ajayre/mpstune-o-matic/PCB/PCB Render.png

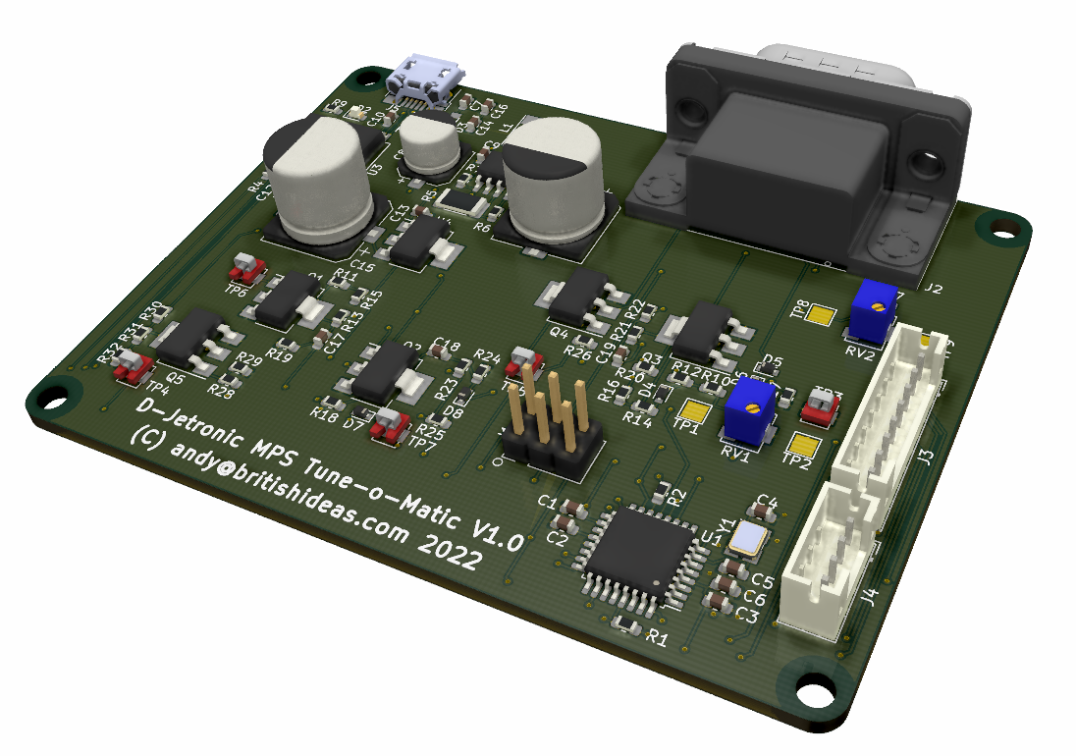
PCB/PCB Render.png
