ajayre/mpstune-o-matic/README.md

# mpstune-o-matic
D-Jetronic MPS Tune-o-Matic
