ajayre/mpstune-o-matic/Software Notes.txt

2. O2 tuned MPSs need to also state fuel pressure.

3. Multiple benchmark O2 tuned MPSs with different fuel pressures so user can choose which one matches their current fuel pressure

9. MPS profile has checkbox "unaltered" so we can automatically generate an average of all unaltered MPSs in the database.

11. Generate stats/report such as % change in pulse width from 0 inHg to 15 inHg
