ajayre/mpstune-o-matic/Simulation/Pressure Loop/AnnotatedSchematics.pptx

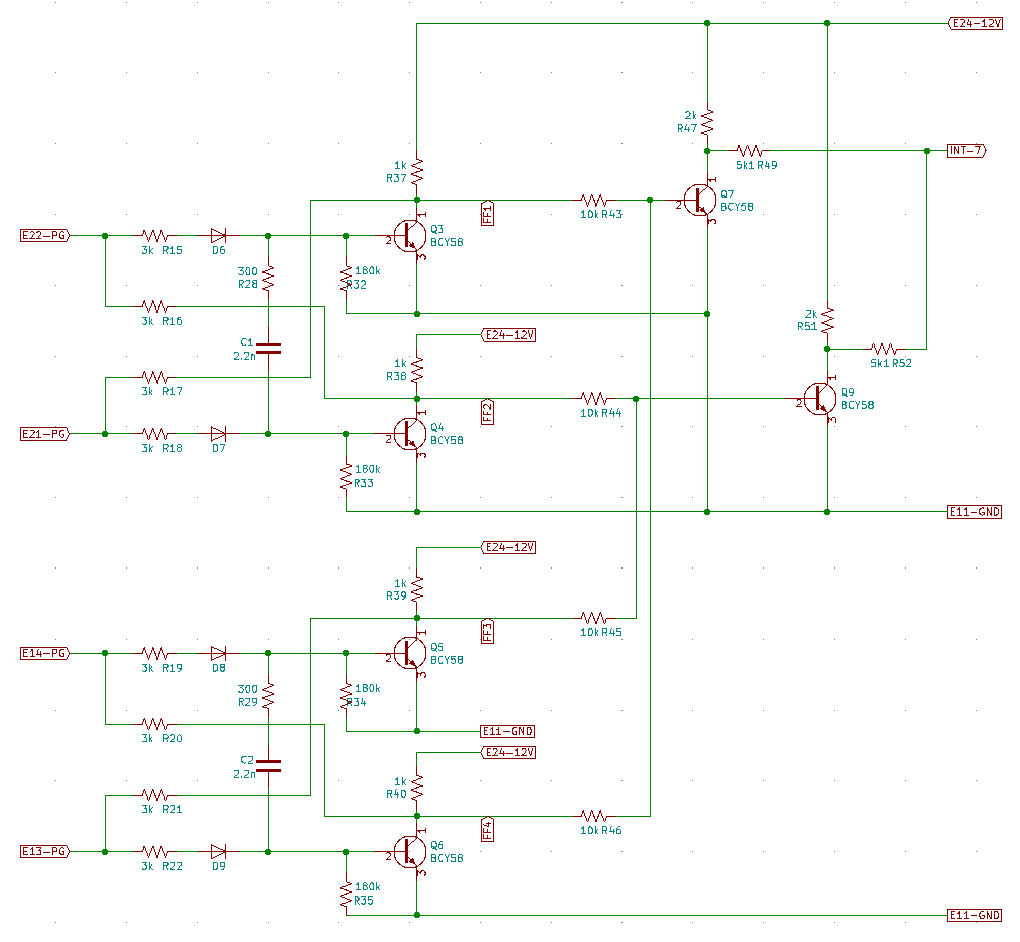
[picture p2: figure]

## Slide 2

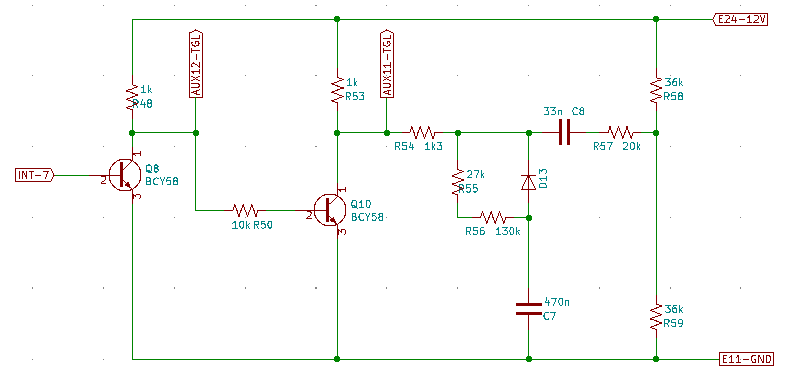
[picture p3: figure]

## Slide 3

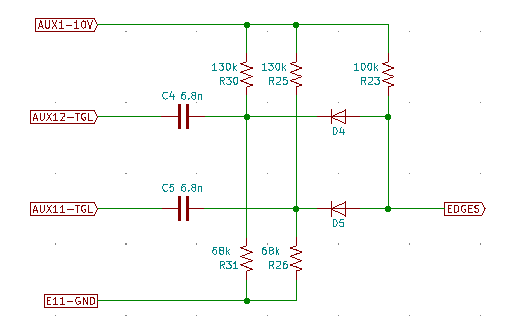
[picture p4: figure]

## Slide 4

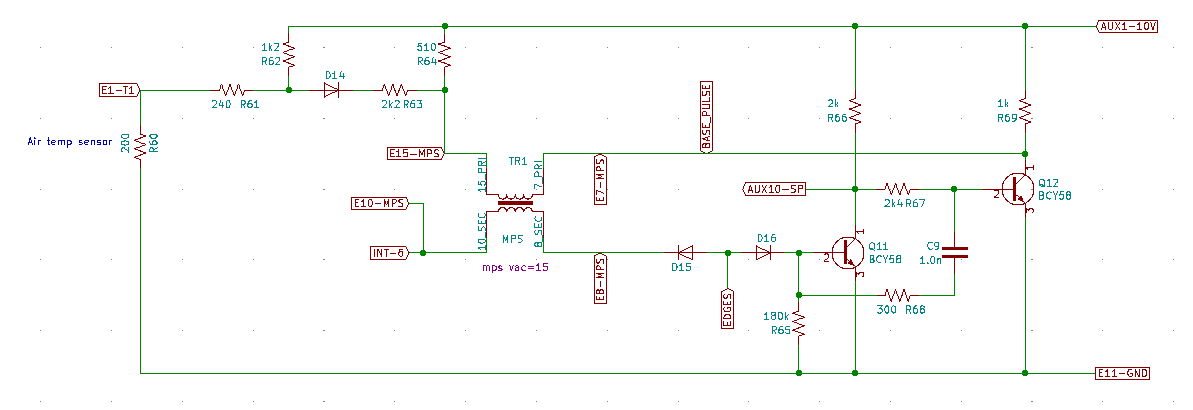
[picture p5: figure]
