ajayre/mpstune-o-matic/Simulation/MPS Stimulator/Waveforms.png

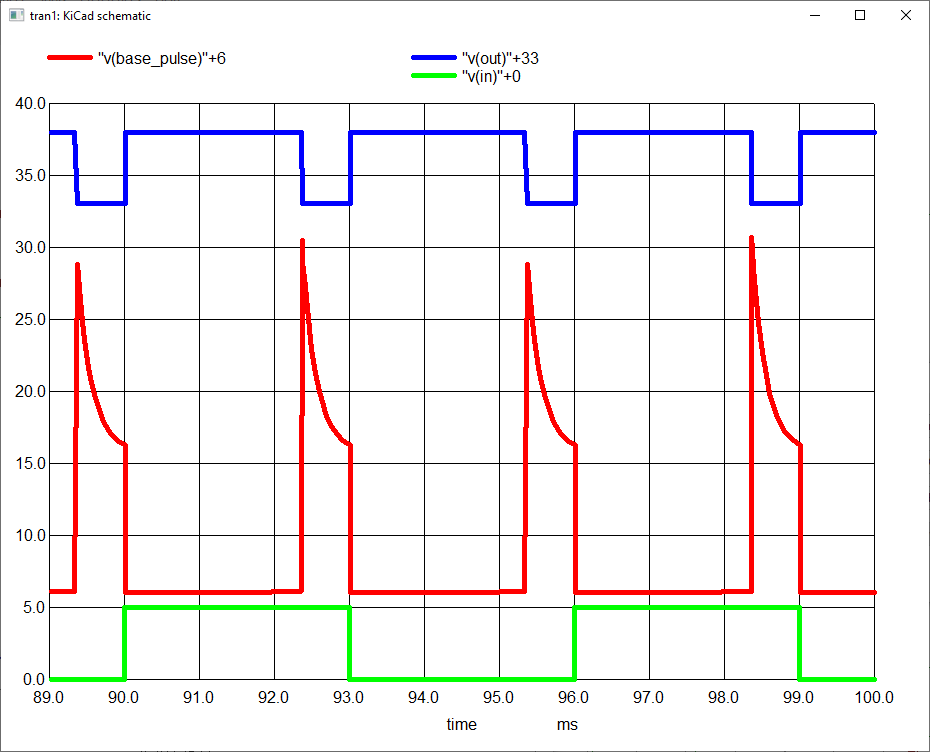
Simulation/MPS Stimulator/Waveforms.png
