ajayre/mpstune-o-matic/Simulation/Pressure Loop/BasePulseGeneration-0inHg.png

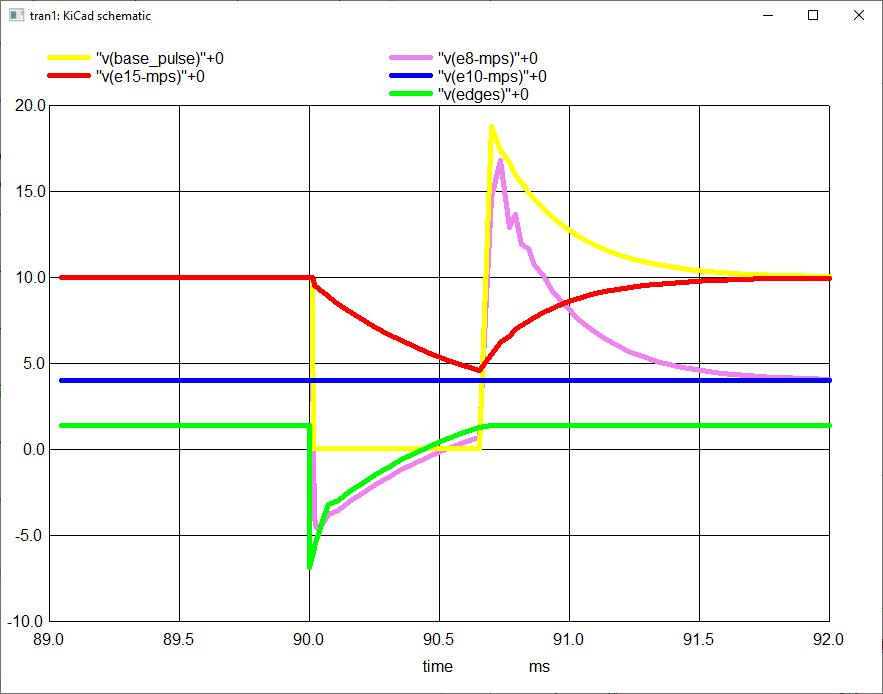
Simulation/Pressure Loop/BasePulseGeneration-0inHg.png
