ajayre/mpstune-o-matic/Simulation/Pressure Loop/BasePulseGeneration-Stacked-0inHg.png

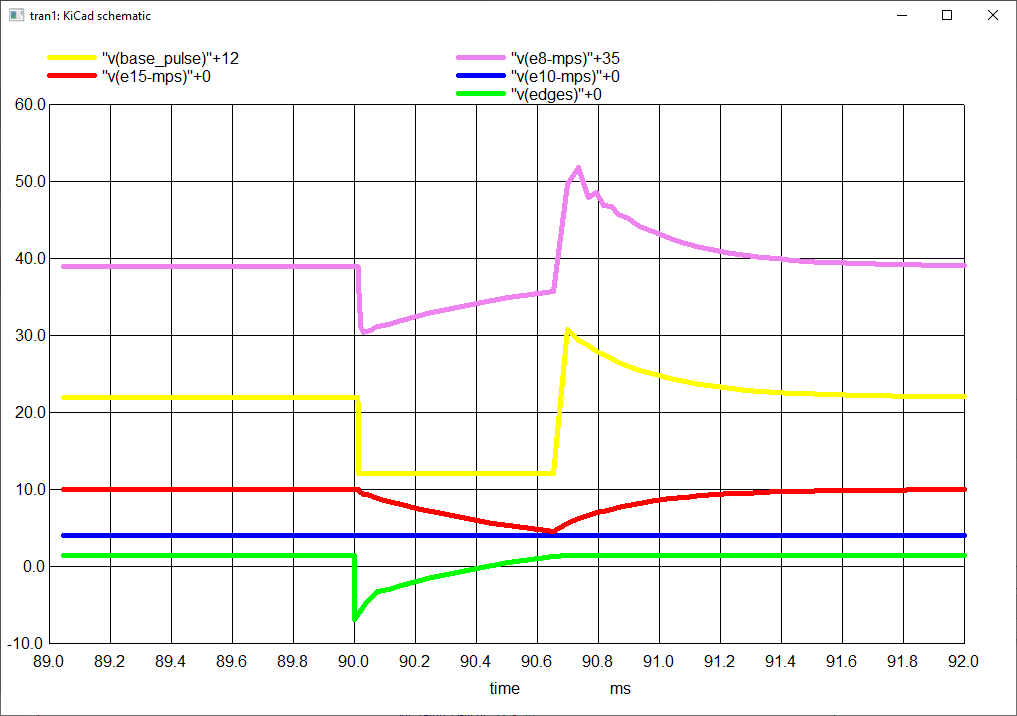
Simulation/Pressure Loop/BasePulseGeneration-Stacked-0inHg.png
