ajayre/mpstune-o-matic/Simulation/Pressure Loop/BasePulseGeneration-Stacked.png

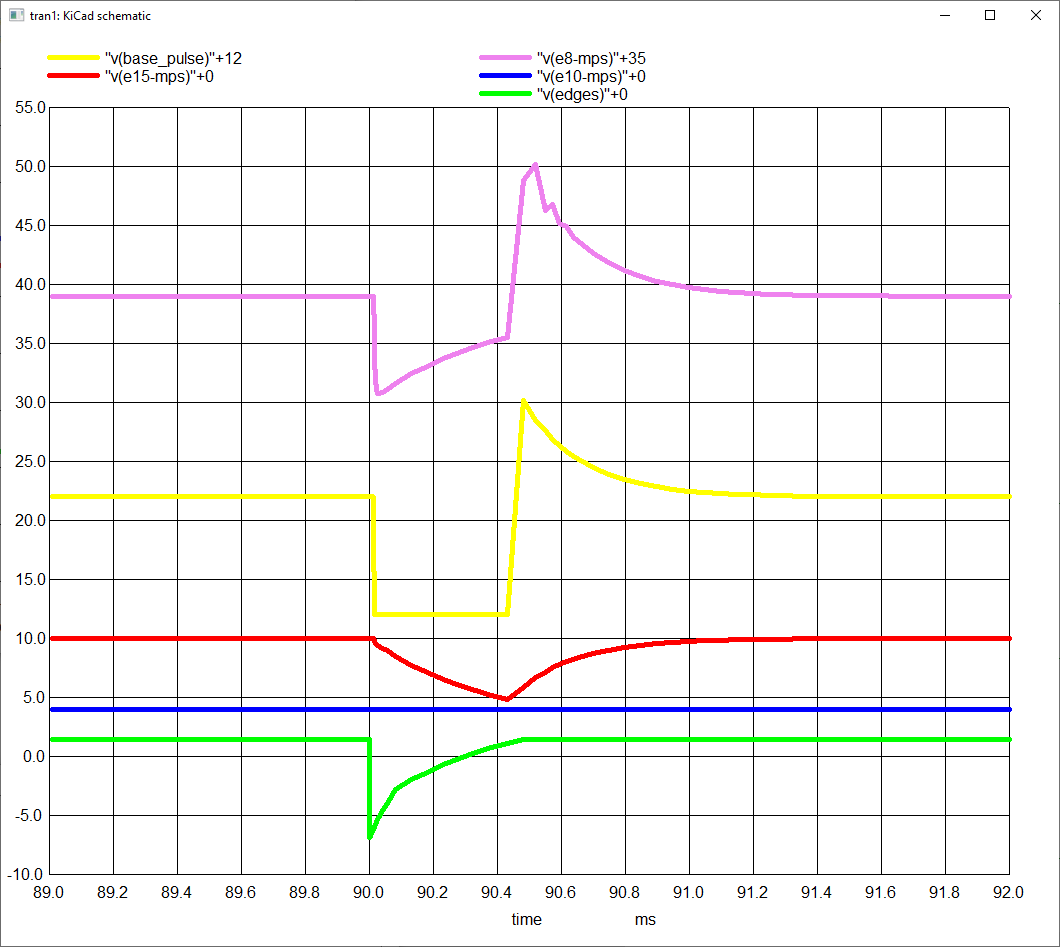
Simulation/Pressure Loop/BasePulseGeneration-Stacked.png
