ajayre/mpstune-o-matic/Simulation/Pressure Loop/BasePulseGeneration.png

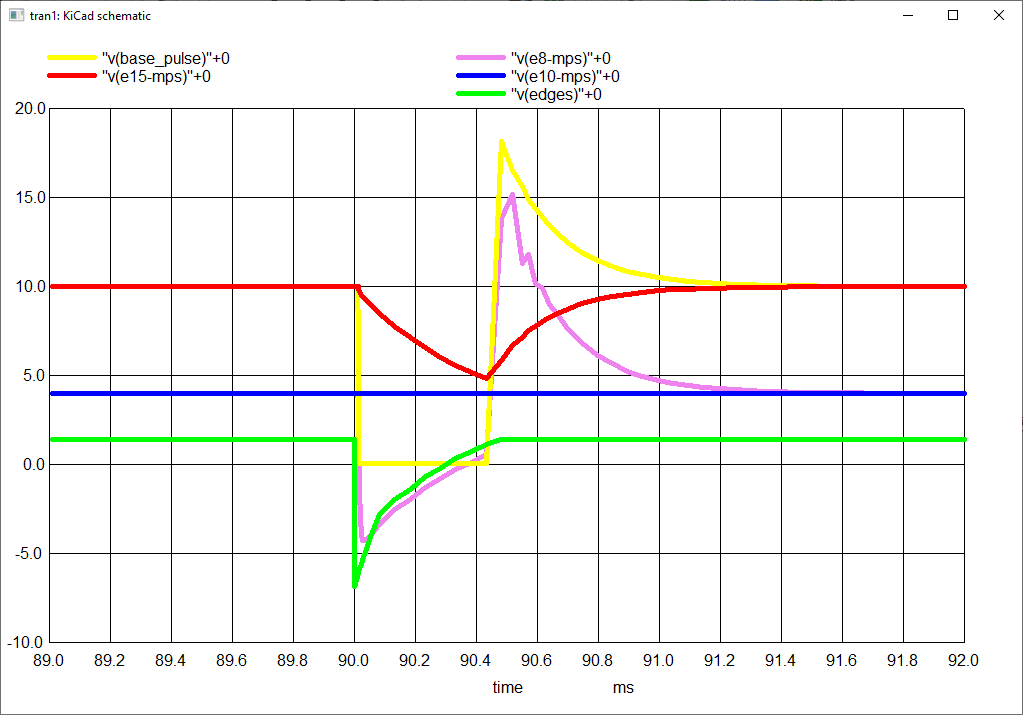
Simulation/Pressure Loop/BasePulseGeneration.png
