ajayre/mpstune-o-matic/Simulation/Pressure Loop/EdgeGeneration-sch-Annotated.png

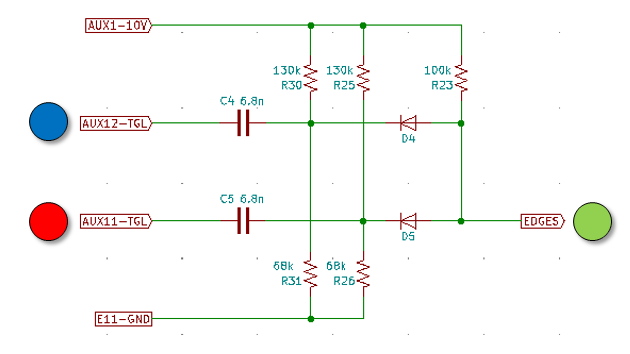
Simulation/Pressure Loop/EdgeGeneration-sch-Annotated.png
