ajayre/mpstune-o-matic/Simulation/Pressure Loop/EdgeGeneration.png

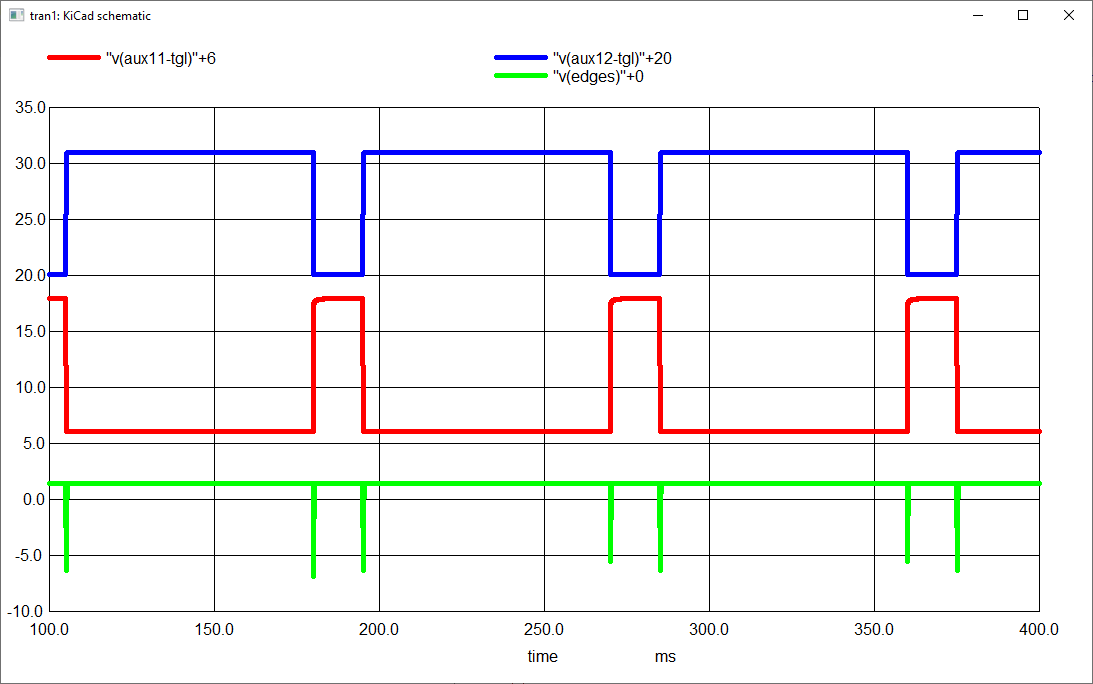
Simulation/Pressure Loop/EdgeGeneration.png
