ajayre/mpstune-o-matic/Simulation/Pressure Loop/EdgeGenerationCloseUp.png

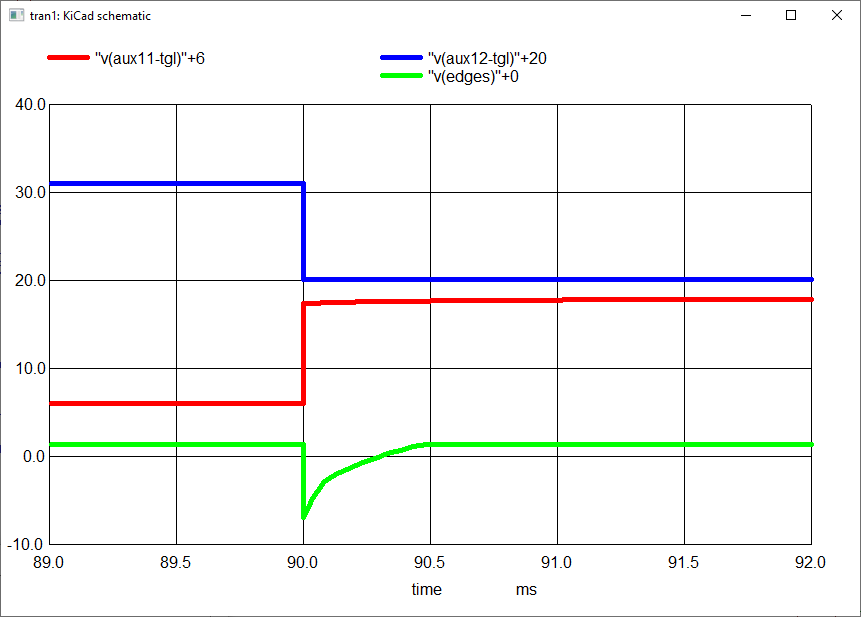
Simulation/Pressure Loop/EdgeGenerationCloseUp.png
