ajayre/mpstune-o-matic/Simulation/Pressure Loop/FlipFlopOutputs.png

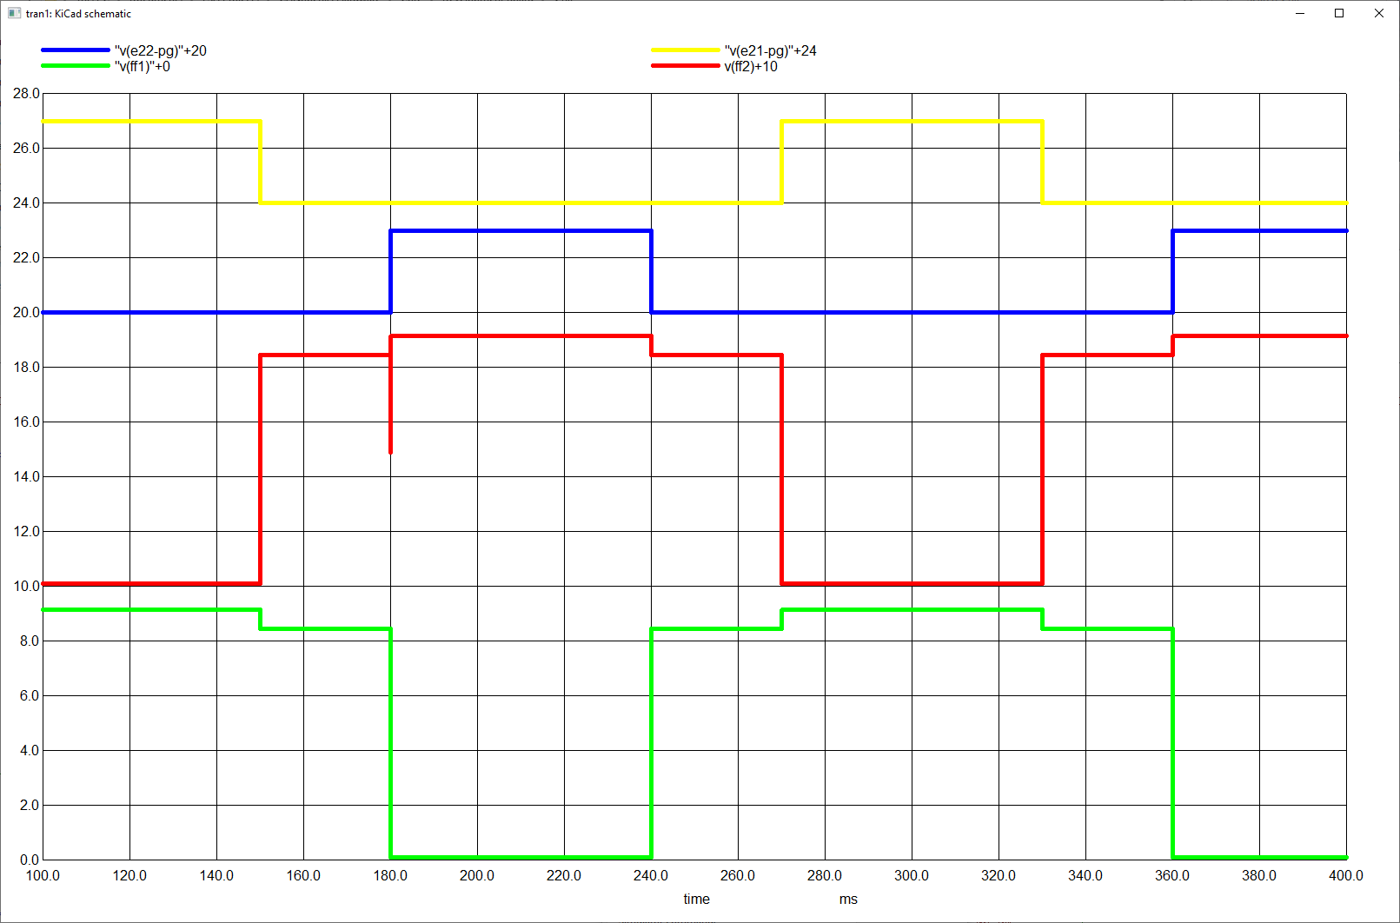
Simulation/Pressure Loop/FlipFlopOutputs.png
