ajayre/mpstune-o-matic/Simulation/Pressure Loop/PressureLoop-sch-Annotated.png

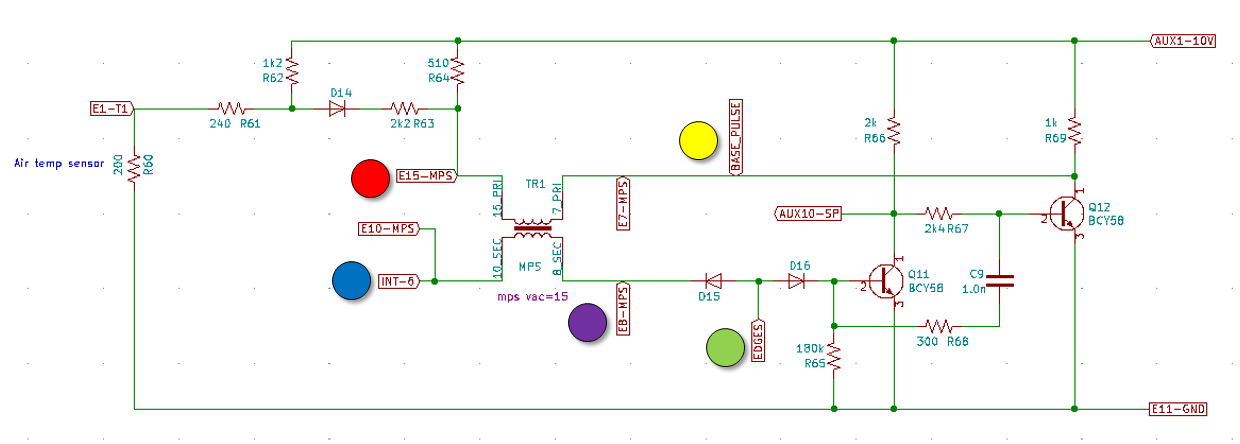
Simulation/Pressure Loop/PressureLoop-sch-Annotated.png
