ajayre/mpstune-o-matic/Simulation/Pressure Loop/PulseGenerator.png

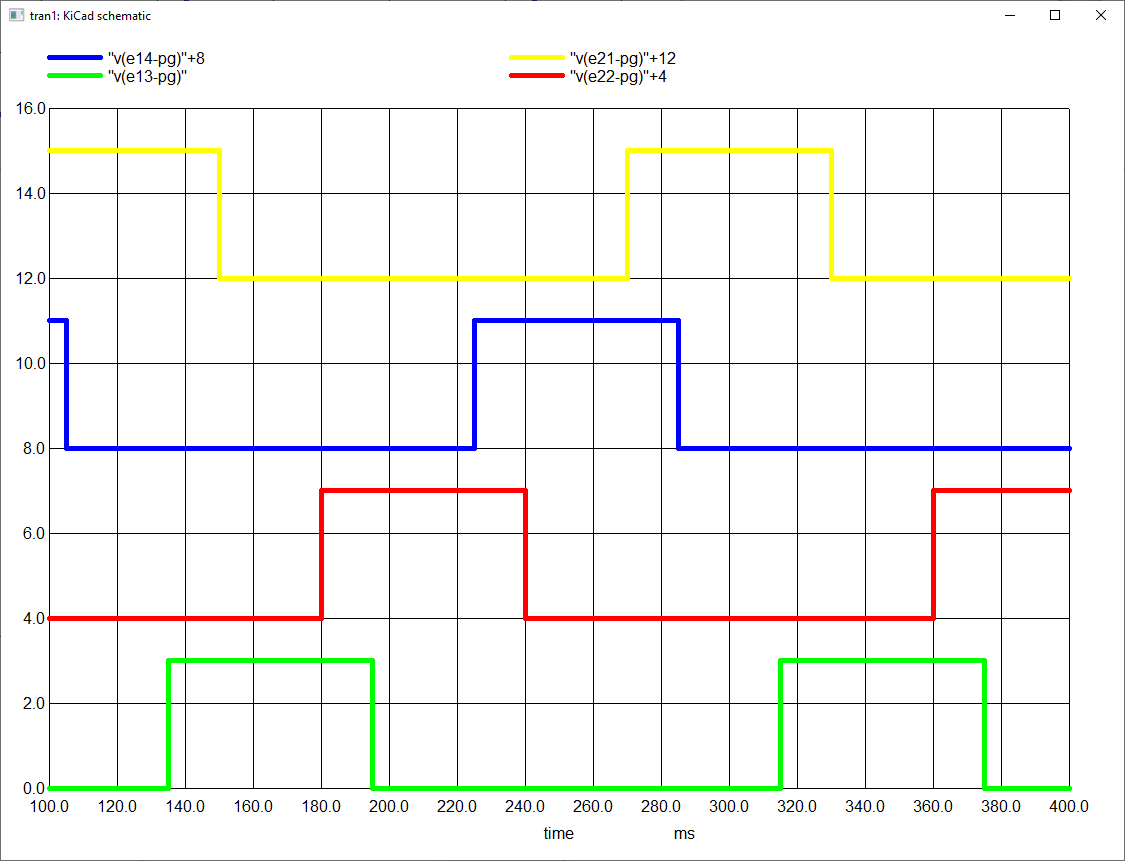
Simulation/Pressure Loop/PulseGenerator.png
