ajayre/mpstune-o-matic/Simulation/Pressure Loop/PulseGeneratorSignalProcessing-sch-Annotated.png

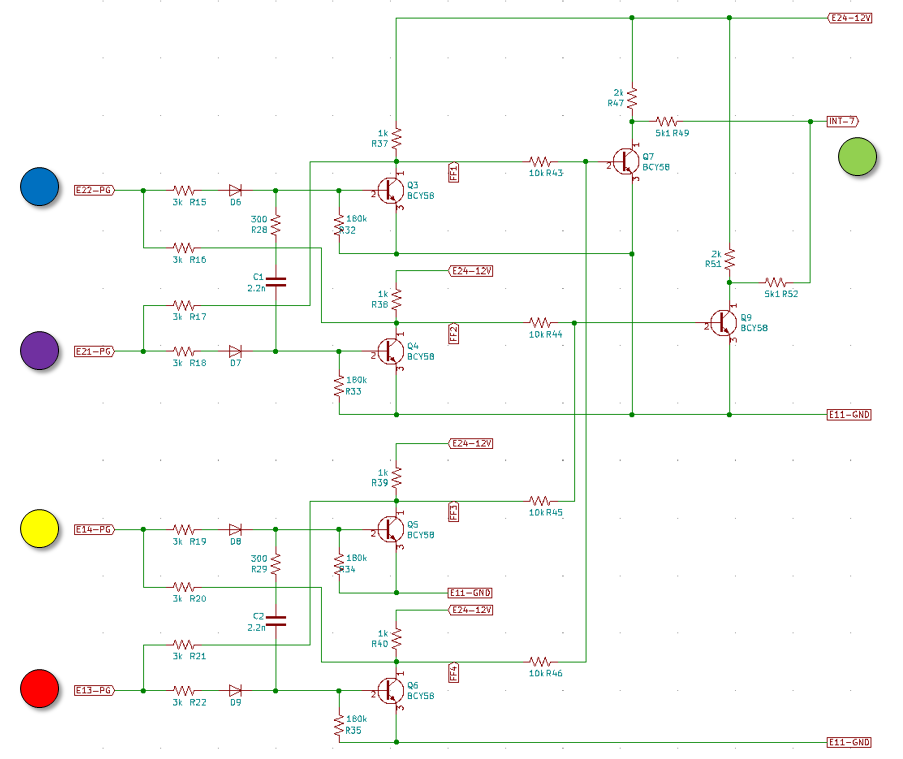
Simulation/Pressure Loop/PulseGeneratorSignalProcessing-sch-Annotated.png
