ajayre/mpstune-o-matic/Simulation/Pressure Loop/PulseGeneratorSignalProcessing.png

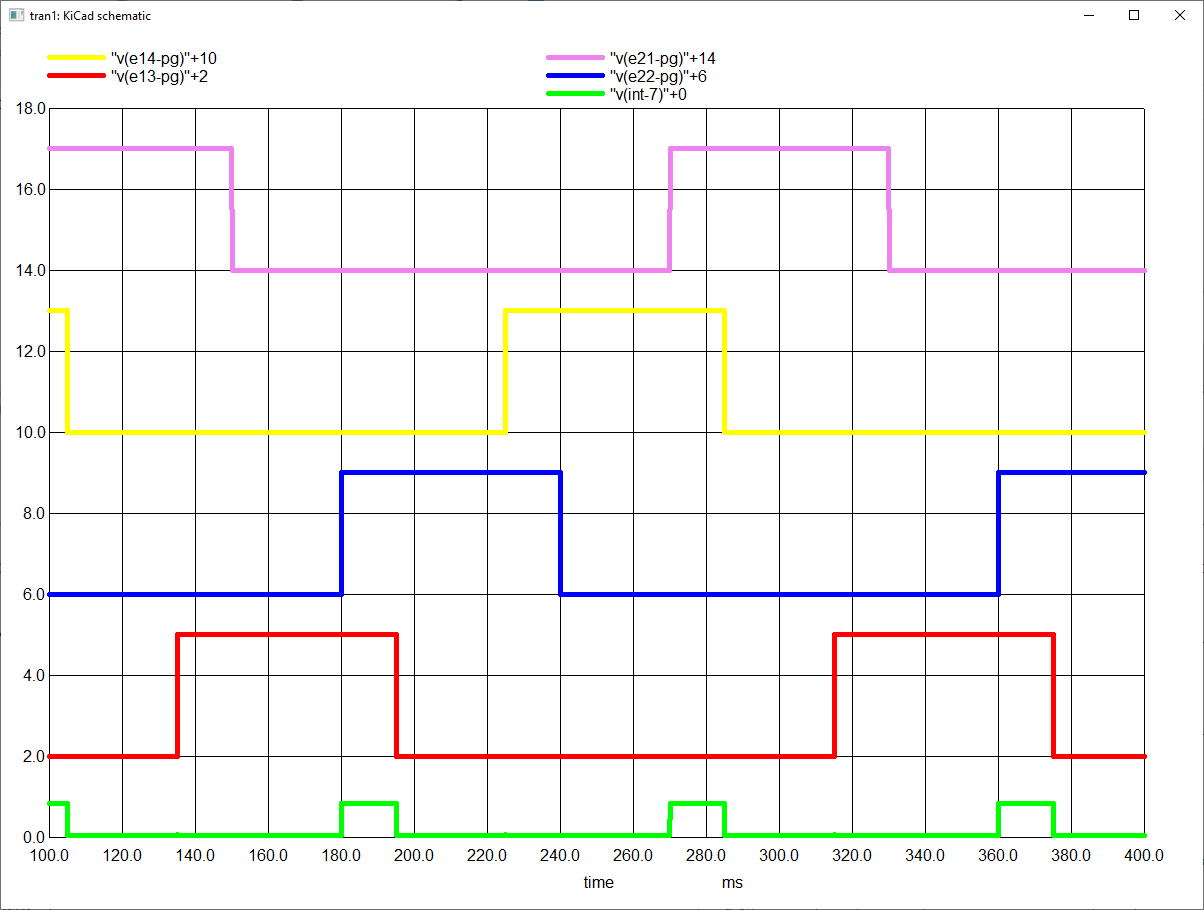
Simulation/Pressure Loop/PulseGeneratorSignalProcessing.png
