ajayre/mpstune-o-matic/Simulation/Pressure Loop/ToggleGeneration-sch-Annotated.png

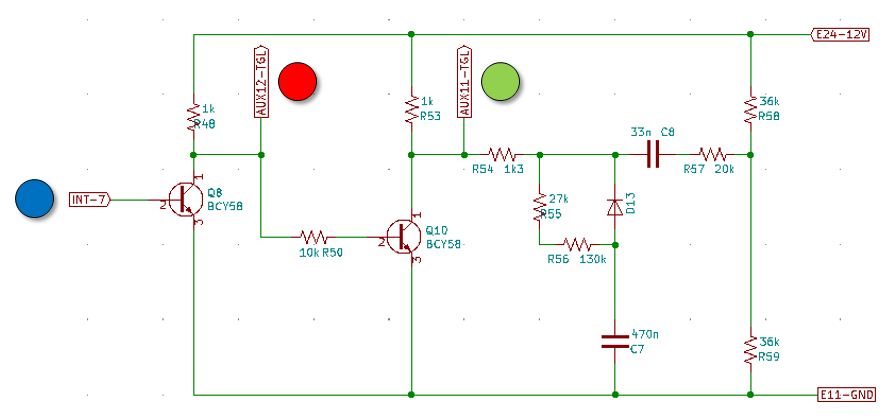
Simulation/Pressure Loop/ToggleGeneration-sch-Annotated.png
