ajayre/mpstune-o-matic/Simulation/Pressure Loop/ToggleGeneration.png

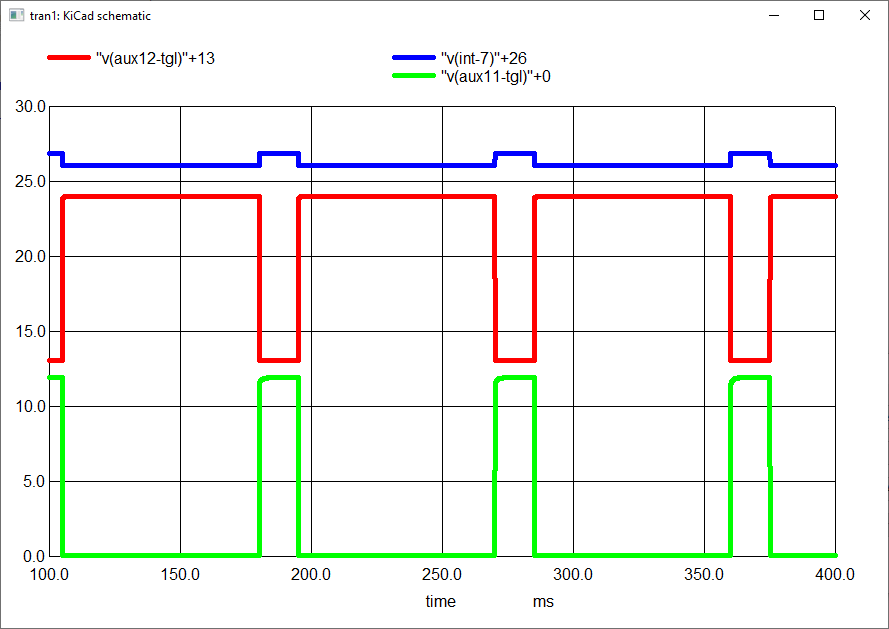
Simulation/Pressure Loop/ToggleGeneration.png
