ajayre/mpstune-o-matic/Case/Top.stl

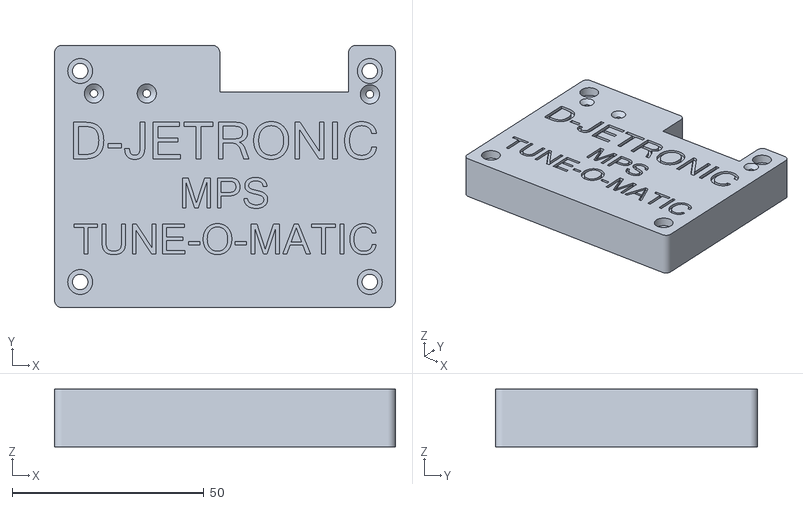
[picture p21: CAD file, 2022-11-11]
Case/Top.stl
88.9 x 68.4 x 15.0
