ajayre/mpstune-o-matic/PCB/Pressure Connector.stp

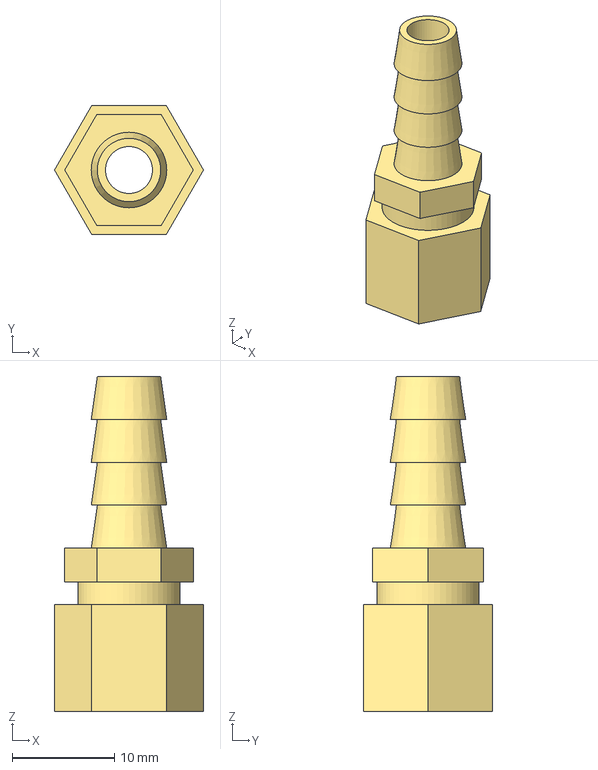
[picture p22: CAD file, 2023-09-29]
PCB/Pressure Connector.stp
14.6 x 12.6 x 32.8 mm
