ajayre/mpstune-o-matic/Case/Bottom.stl

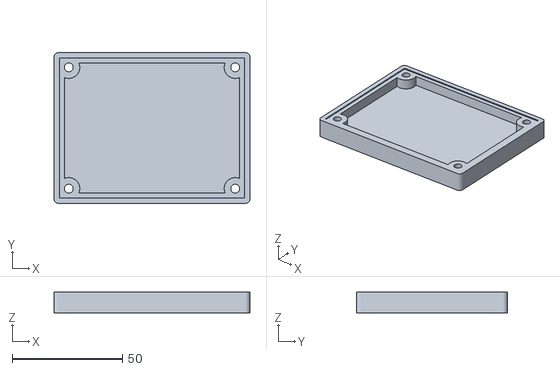
[picture p23: CAD file, 2022-11-01]
Case/Bottom.stl
88.9 x 68.4 x 9.50
