ajayre/mpstune-o-matic/PCB/MPS-Tune-o-Matic-V1.1-Schematic.pdf

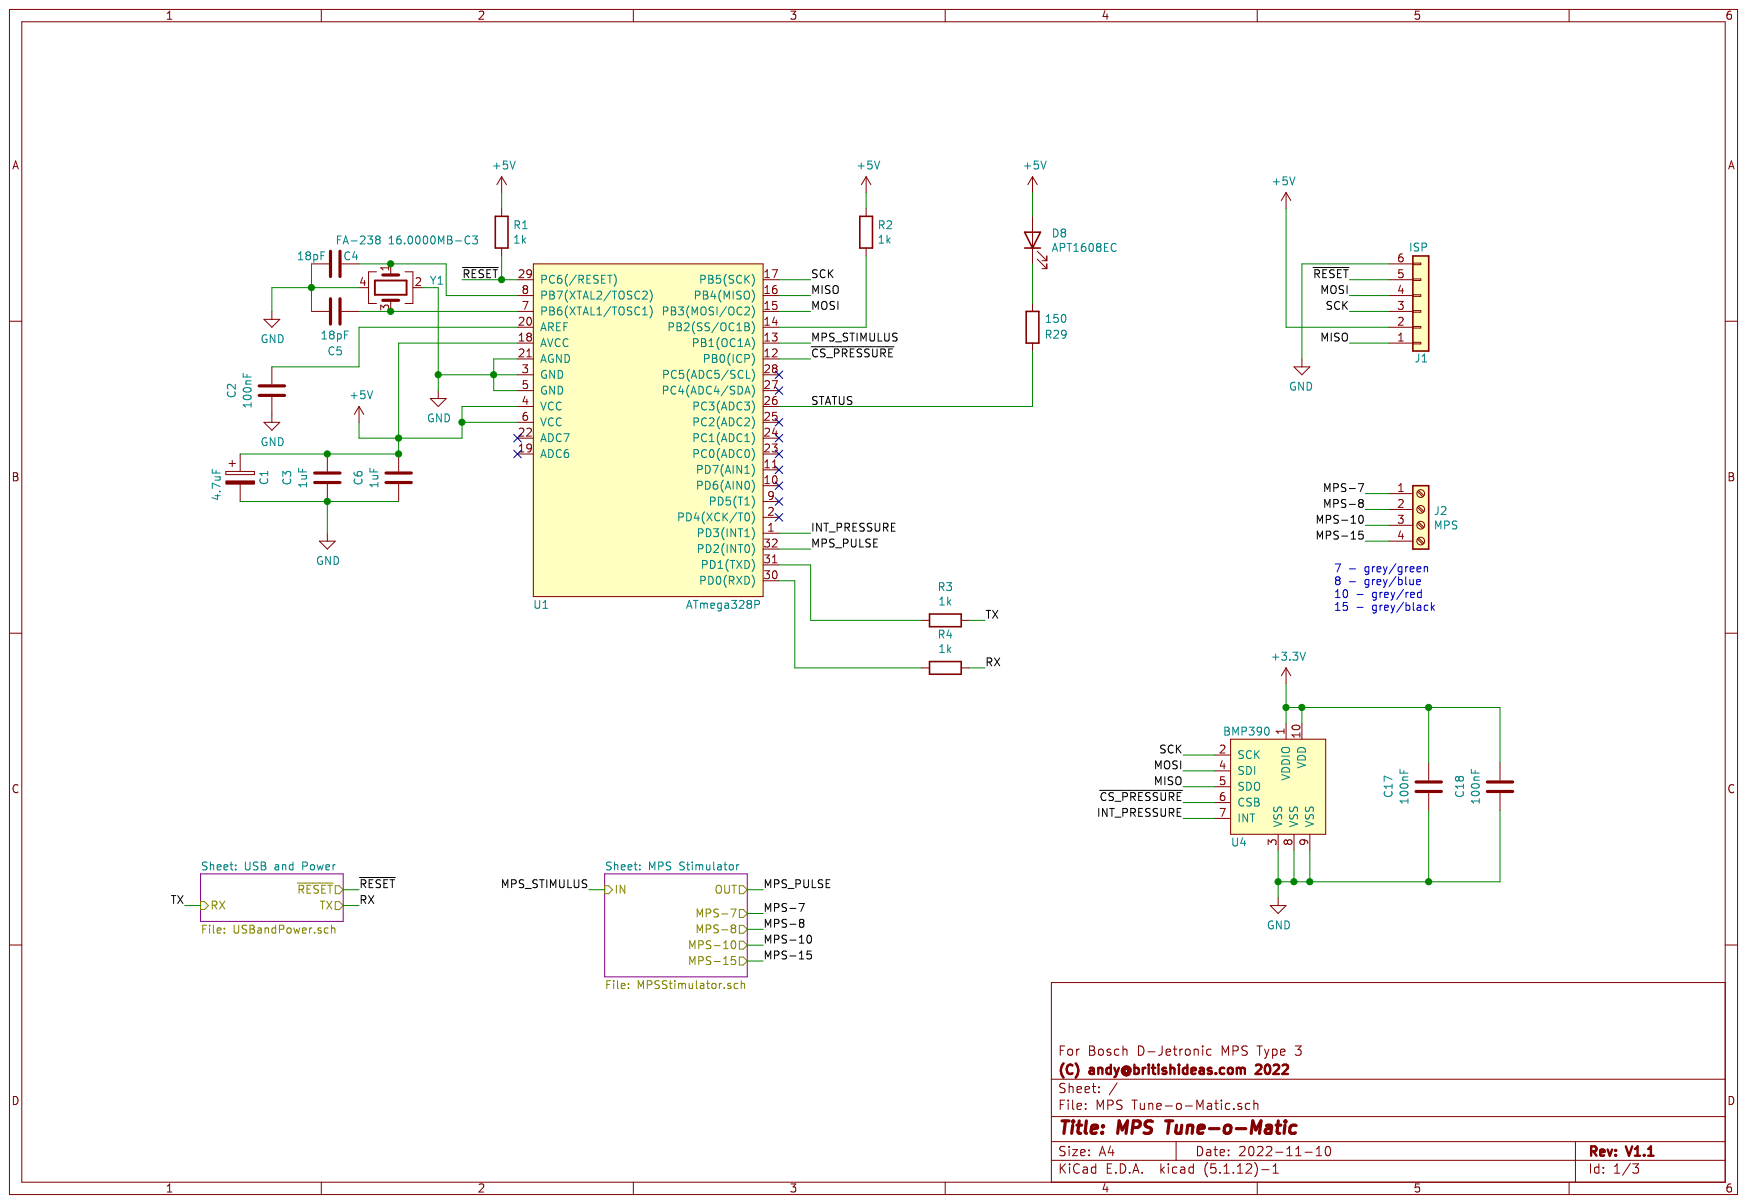
[picture p24: page 1]

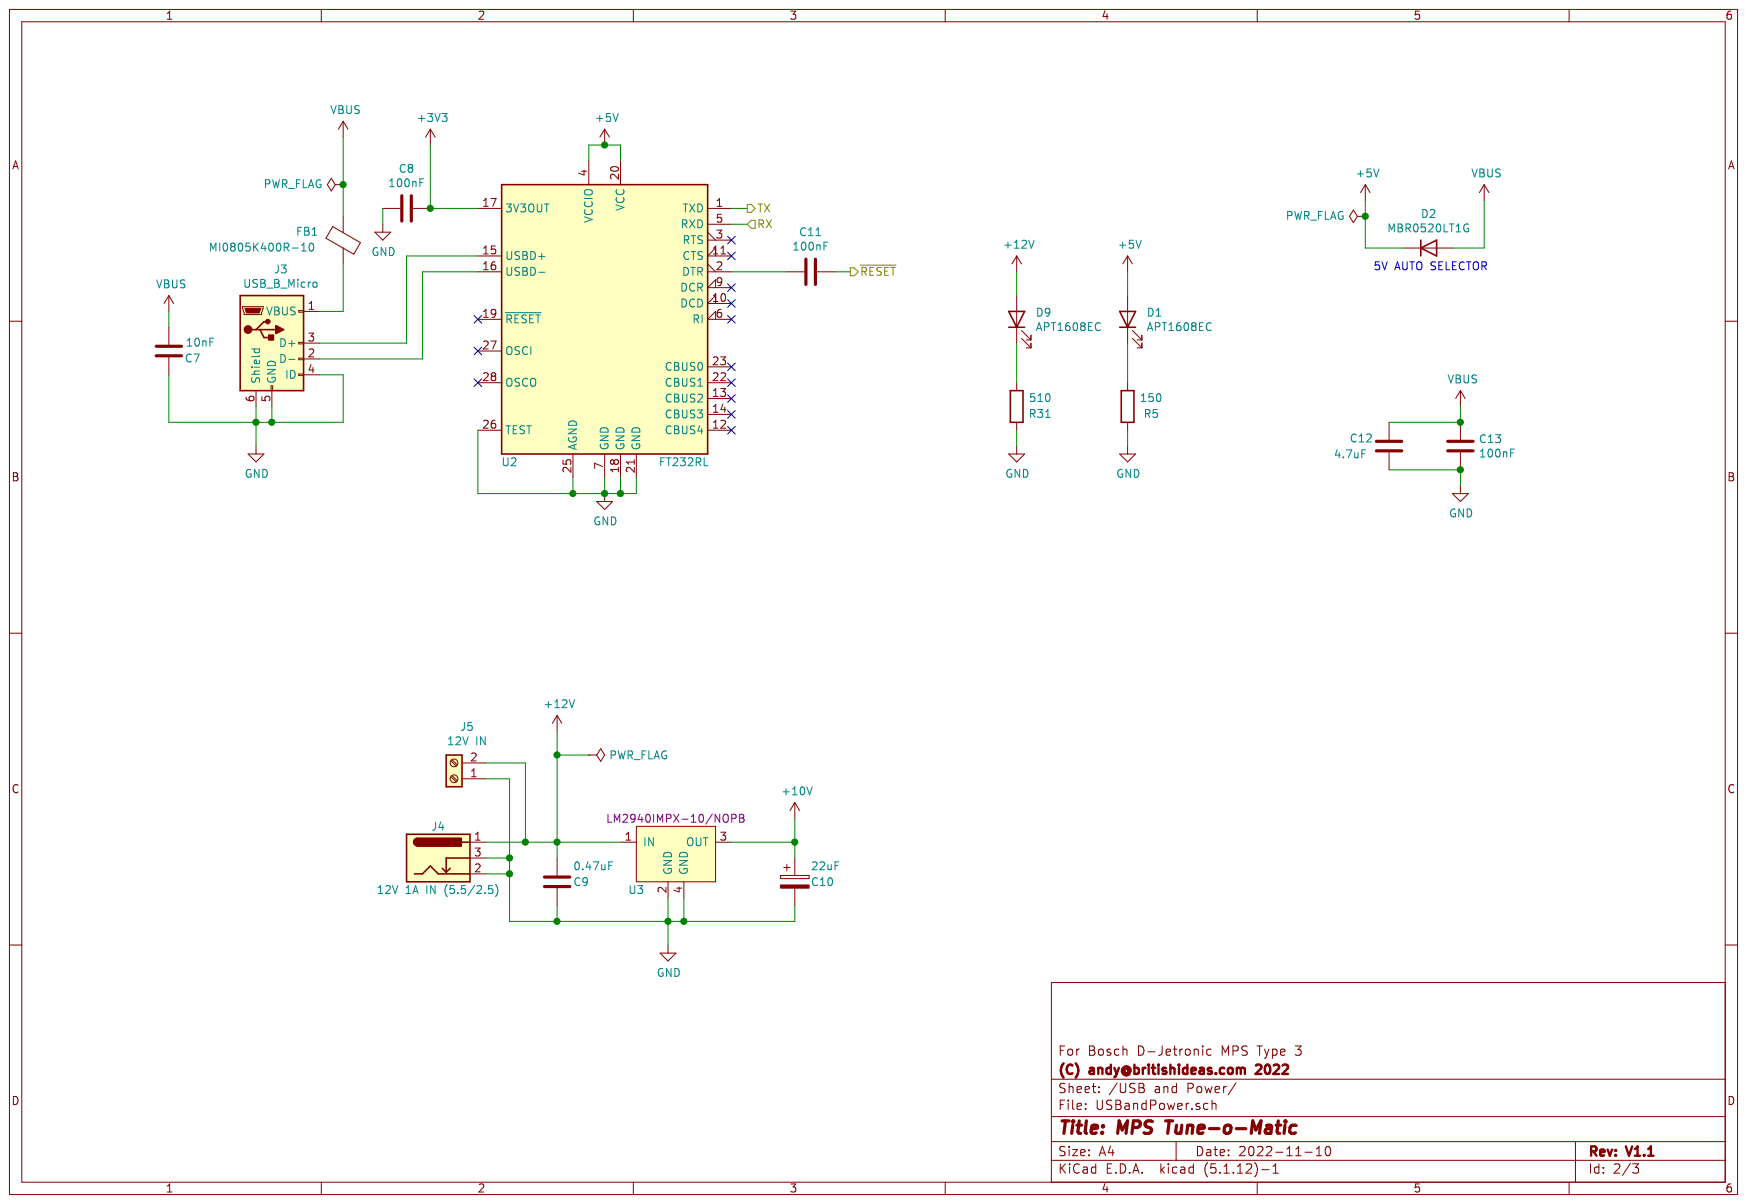
[picture p25: page 2]

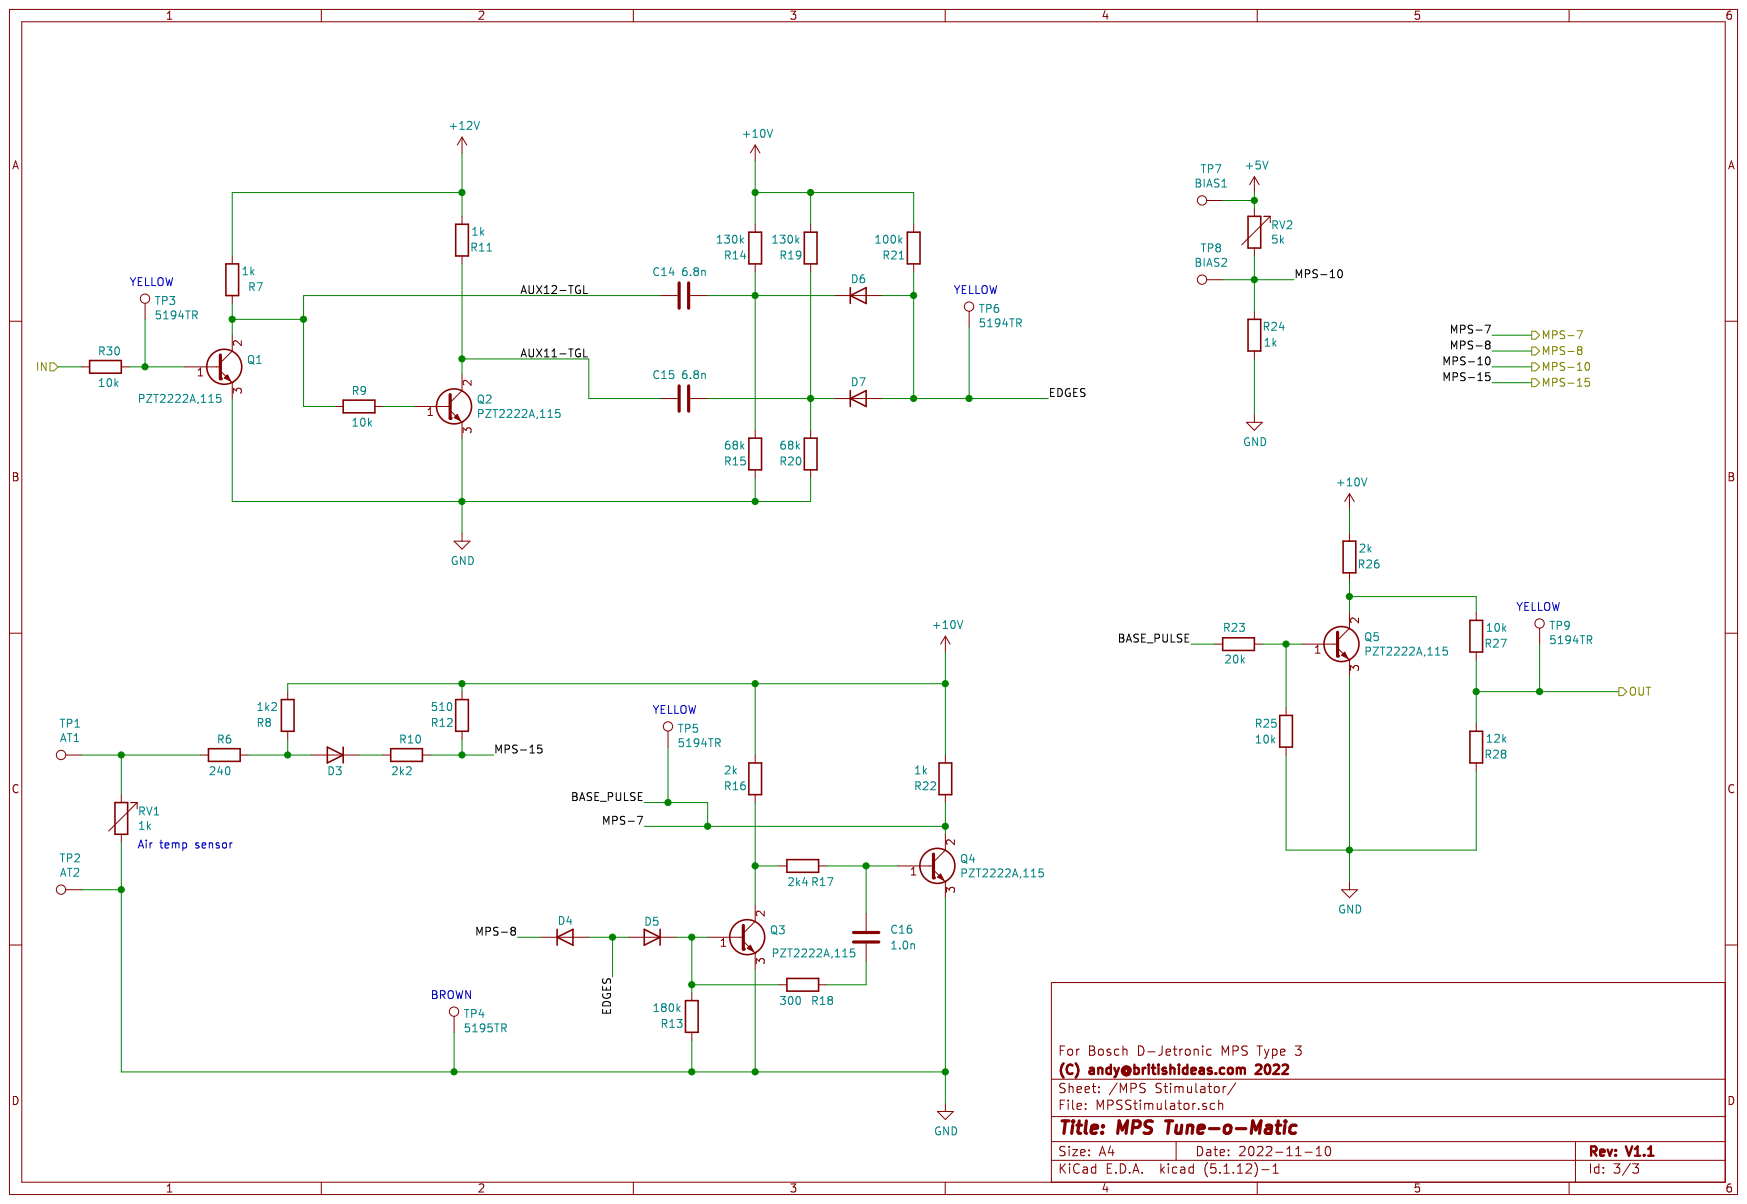
[picture p26: page 3]
