ajayre/mpstune-o-matic/PCB/MPS Tune-o-Matic.kicad_pcb

## KiCad design PCB/MPS Tune-o-Matic.kicad_pcb (2023-09-29)

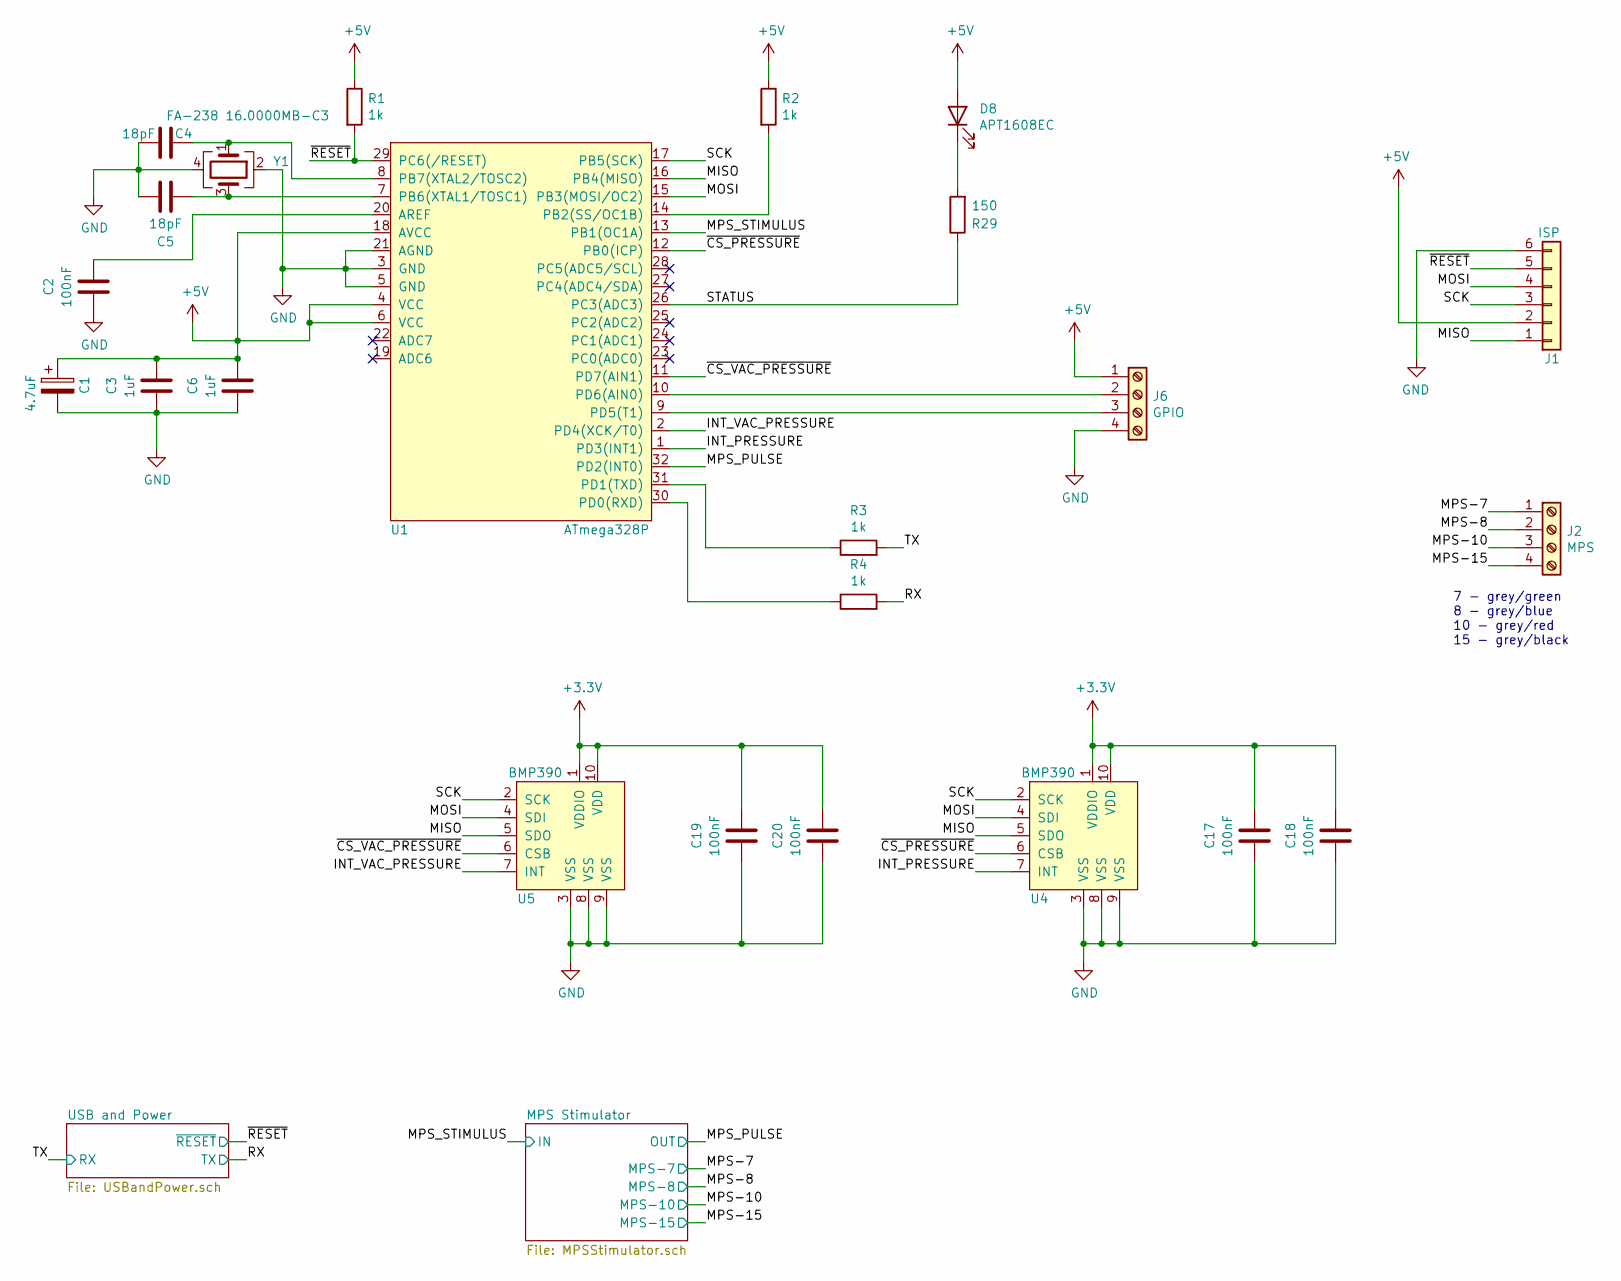
[picture p27: schematic MPS Tune-o-Matic.sch]

Parts:
C1: 4.7uF; C_0603_1608Metric
C2, C17, C18, C19, C20: 100nF; C_0603_1608Metric
C3, C6: 1uF; C_0603_1608Metric
C4, C5: 18pF; C_0603_1608Metric
D8: APT1608EC; LED_0603_1608Metric
J1: ISP; PinHeader_2x03_P2.54mm_Vertical
J2: MPS; PhoenixContact_COMBICON_PT_4
J6: GPIO; PhoenixContact_COMBICON_PT_4
R1, R2, R3, R4: 1k; R_0603_1608Metric
R29: 150; R_0603_1608Metric
U1: ATmega328P; LQFP-32_7x7mm_P0.8mm
U4, U5: BMP390; LGA-2x2-10-pin
Y1: FA-238 16.0000MB-C3; FA-238

Connections:
+5V: C1.1, C3.1, C6.1, D8.2 (A), J1.2, J6.1, R1.1, R2.1, U1.4 (VCC), U1.6 (VCC), U1.18 (AVCC); also elsewhere on the board
/INT_PRESSURE: U1.1 (PD3(INT1)), U4.7 (INT)
/INT_VAC_PRESSURE: U1.2 (PD4(XCK/T0)), U5.7 (INT)
/MISO: J1.1, U1.16 (PB4(MISO)), U4.5 (SDO), U5.5 (SDO)
/MOSI: J1.4, U1.15 (PB3(MOSI/OC2)), U4.4 (SDI), U5.4 (SDI)
/MPS-7: J2.1; also elsewhere on the board
/MPS-8: J2.2; also elsewhere on the board
/MPS-10: J2.3; also elsewhere on the board
/MPS-15: J2.4; also elsewhere on the board
/MPS_PULSE: U1.32 (PD2(INT0)); also elsewhere on the board
/MPS_STIMULUS: U1.13 (PB1(OC1A)); also elsewhere on the board
/RX: R4.2; also elsewhere on the board
/SCK: J1.3, U1.17 (PB5(SCK)), U4.2 (SCK), U5.2 (SCK)
/STATUS: R29.1, U1.26 (PC3(ADC3))
/TX: R3.2; also elsewhere on the board
/~CS_PRESSURE: U1.12 (PB0(ICP)), U4.6 (CSB)
/~CS_VAC_PRESSURE: U1.11 (PD7(AIN1)), U5.6 (CSB)
/~RESET: J1.5, R1.2, U1.29 (PC6(/RESET)); also elsewhere on the board
GND: C1.2, C2.2, C3.2, C4.2, C5.1, C6.2, C17.2, C18.2, C19.2, C20.2, J1.6, J6.4, U1.3 (GND), U1.5 (GND), U1.21 (AGND), U4.3 (VSS), U4.8 (VSS), U4.9 (VSS), U5.3 (VSS), U5.8 (VSS), U5.9 (VSS), Y1.2, Y1.4; also elsewhere on the board
unnamed: C2.1, U1.20 (AREF)
unnamed: C4.1, U1.8 (PB7(XTAL2/TOSC2)), Y1.1
unnamed: C5.2, U1.7 (PB6(XTAL1/TOSC1)), Y1.3
unnamed: D8.1 (K), R29.2
unnamed: J6.2, U1.10 (PD6(AIN0))
unnamed: J6.3, U1.9 (PD5(T1))
unnamed: R2.2, U1.14 (PB2(SS/OC1B))
unnamed: R3.1, U1.31 (PD1(TXD))
unnamed: R4.1, U1.30 (PD0(RXD))

Notes on the sheet:
7 - grey/green 8 - grey/blue 10 - grey/red 15 - grey/black

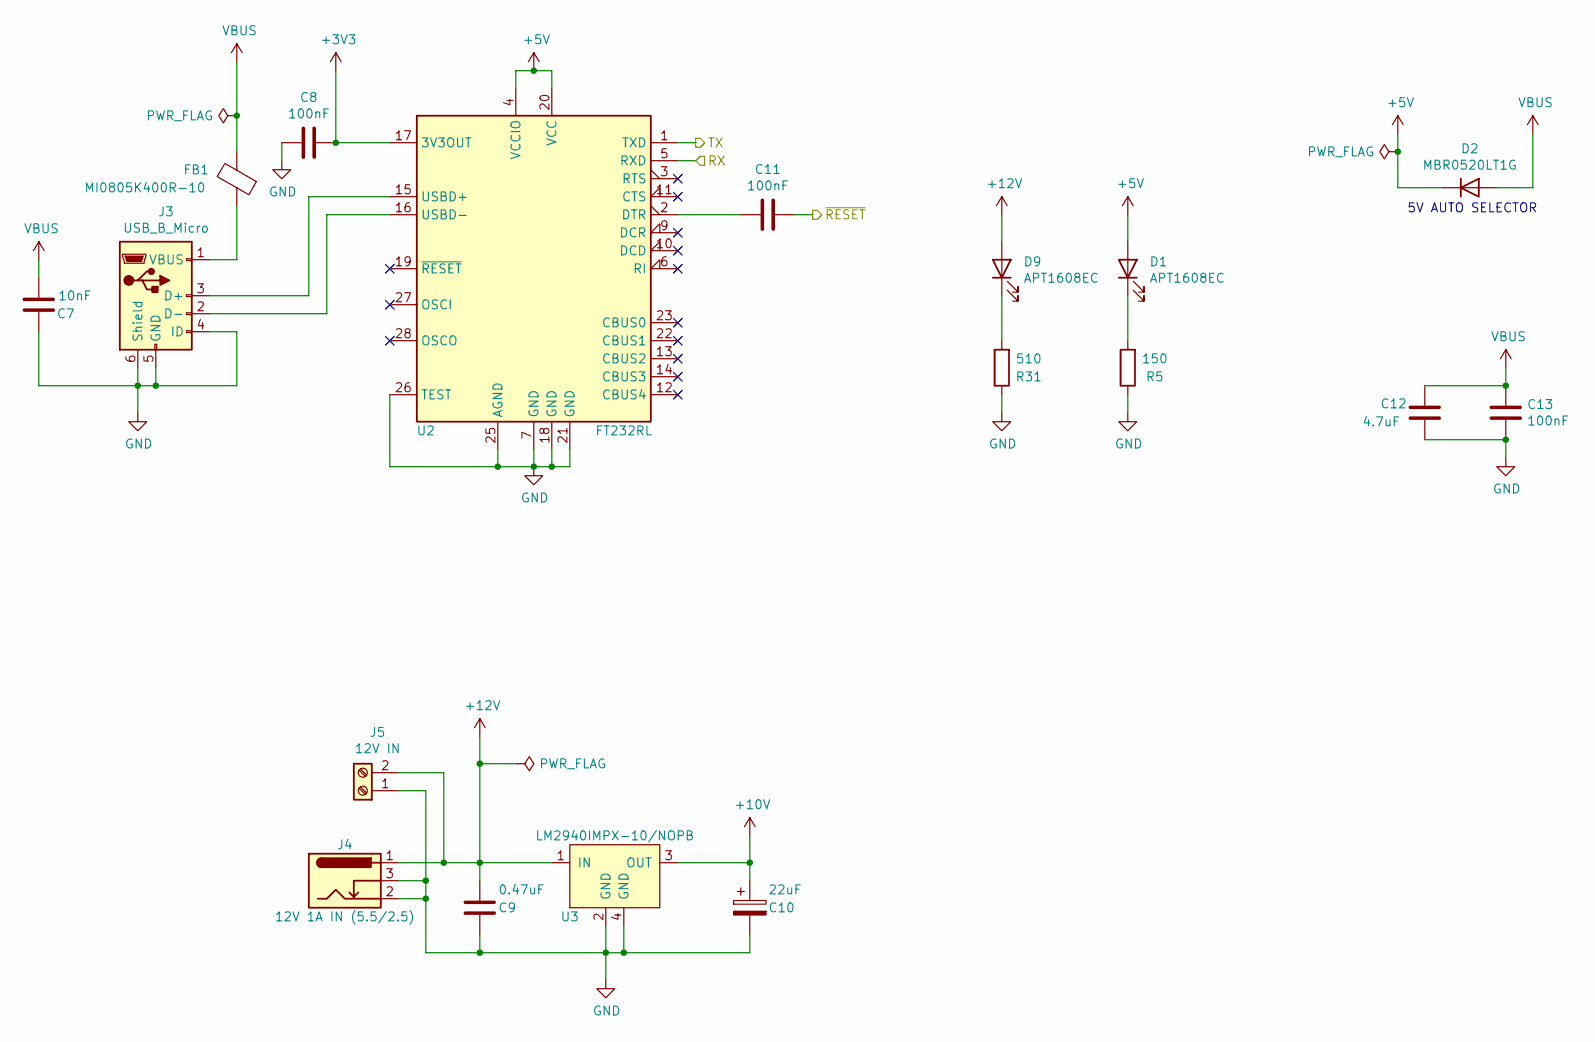
[picture p28: schematic USBandPower.sch, MPS Tune-o-Matic]

Parts:
C7: 10nF; C_0603_1608Metric
C8, C11, C13: 100nF; C_0603_1608Metric
C9: 0.47uF; C_0603_1608Metric
C10: 22uF; CP_Elec_10x10.5
C12: 4.7uF; C_0603_1608Metric
D1, D9: APT1608EC; LED_0603_1608Metric
D2: MBR0520LT1G; SOD-123
FB1: MI0805K400R-10; R_0805_2012Metric
J3: USB_B_Micro; USB_Micro-B_Amphenol_10103594-0001LF_Horizontal
J4: 12V 1A IN (5.5/2.5); BarrelJack_Wuerth_6941xx301002
J5: 12V IN; PhoenixContact_COMBICON_MKDSN_2
R5: 150; R_0603_1608Metric
R31: 510; R_0603_1608Metric
U2: FT232RL; SSOP-28_5.3x10.2mm_P0.65mm
U3: LM2940; SOT-223

Connections:
+5V: D1.2 (A), D2.1 (K), U2.4 (VCCIO), U2.20 (VCC); also elsewhere on the board
+10V: C10.1, U3.3 (OUT); also elsewhere on the board
+12V: C9.1, D9.2 (A), J4.1, J5.2, U3.1 (IN); also elsewhere on the board
/RX: U2.1 (TXD); also elsewhere on the board
/TX: U2.5 (RXD); also elsewhere on the board
/~RESET: C11.1; also elsewhere on the board
GND: C7.1, C8.2, C9.2, C10.2, C12.2, C13.2, J3.4 (ID), J3.5 (GND), J3.6 (Shield), J4.2, J4.3, J5.1, R5.1, R31.1, U2.7 (GND), U2.18 (GND), U2.21 (GND), U2.25 (AGND), U2.26 (TEST), U3.2 (GND), U3.4 (GND); also elsewhere on the board
unnamed: C11.2, U2.2 (DTR)
unnamed: D1.1 (K), R5.2
unnamed: D9.1 (K), R31.2
unnamed: FB1.1, J3.1 (VBUS)
unnamed: J3.2 (D-), U2.16 (USBD-)
unnamed: J3.3 (D+), U2.15 (USBD+)
VBUS: C7.2, C12.1, C13.1, D2.2 (A), FB1.2

Notes on the sheet:
5V AUTO SELECTOR

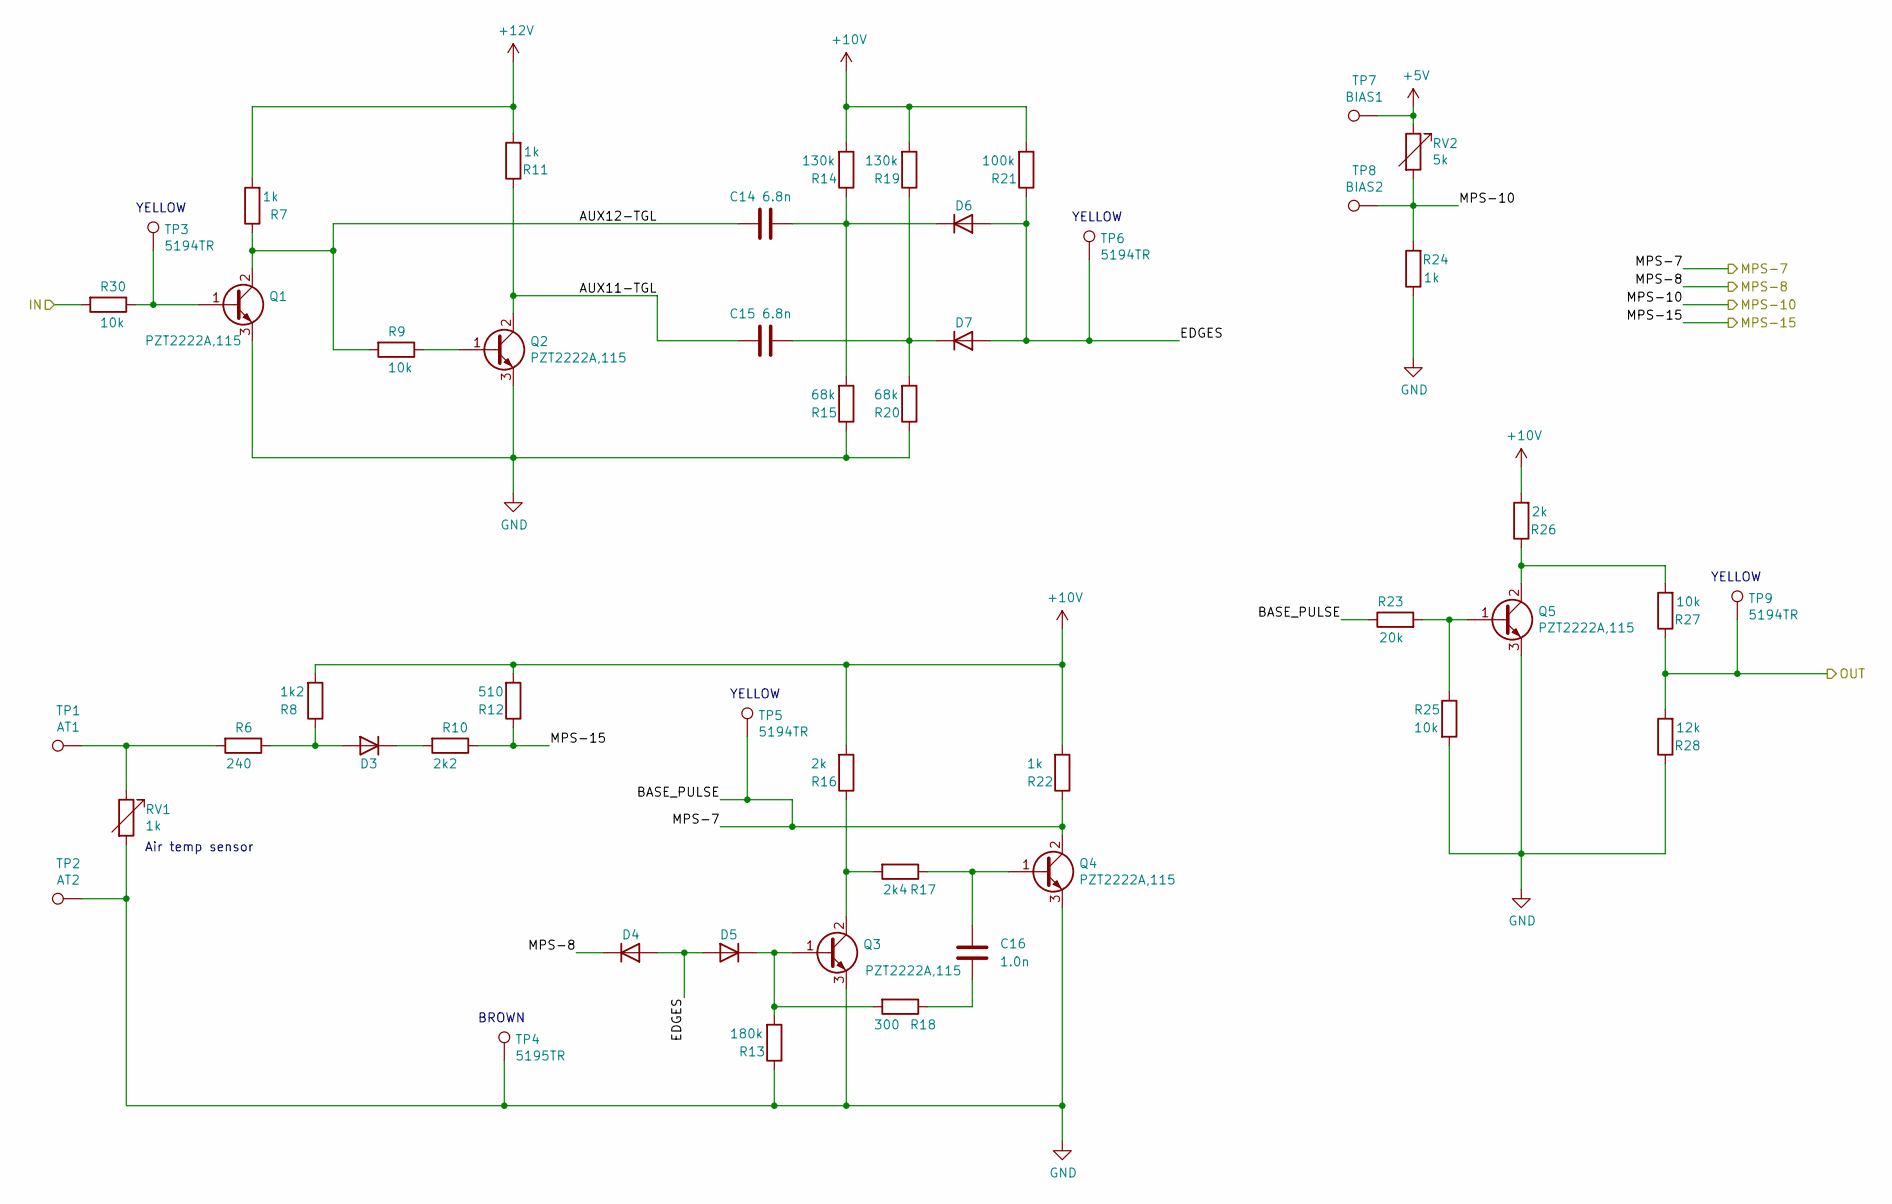
[picture p29: schematic MPSStimulator.sch, MPS Tune-o-Matic]

Parts:
C14, C15: 6.8n; C_0603_1608Metric
C16: 1.0n; C_0603_1608Metric
D3, D4, D5, D6, D7: RB520SM-30T2R; D_SOD-523
Q1, Q2, Q3, Q4, Q5: PZT2222A,115; SOT-223-3_TabPin2
R6: 240; R_0603_1608Metric
R7, R11, R22, R24: 1k; R_0603_1608Metric
R8: 1k2; R_0603_1608Metric
R9, R25, R27, R30: 10k; R_0603_1608Metric
R10: 2k2; R_0603_1608Metric
R12: 510; R_0603_1608Metric
R13: 180k; R_0603_1608Metric
R14, R19: 130k; R_0603_1608Metric
R15, R20: 68k; R_0603_1608Metric
R16, R26: 2k; R_0603_1608Metric
R17: 2k4; R_0603_1608Metric
R18: 300; R_0603_1608Metric
R21: 100k; R_0603_1608Metric
R23: 20k; R_0603_1608Metric
R28: 12k; R_0603_1608Metric
RV1: 1k; Surface_Mount_Cermet_Trimmer_SM-42-43W
RV2: 5k; Surface_Mount_Cermet_Trimmer_SM-42-43W
TP1: AT1; TestPoint_Pad_2.0x2.0mm
TP2: AT2; TestPoint_Pad_2.0x2.0mm
TP3, TP5, TP6, TP9: 5194TR; 5190TR-Colored-Test-Point
TP4: 5195TR; 5190TR-Colored-Test-Point
TP7: BIAS1; TestPoint_Pad_2.0x2.0mm
TP8: BIAS2; TestPoint_Pad_2.0x2.0mm

Connections:
+5V: RV2.1, TP7.1; also elsewhere on the board
+10V: R8.2, R12.2, R14.2, R16.2, R19.2, R21.2, R22.2, R26.2; also elsewhere on the board
+12V: R7.2, R11.2; also elsewhere on the board
/MPS Stimulator/AUX11-TGL: C15.1, Q2.2 (C), R11.1
/MPS Stimulator/AUX12-TGL: C14.1, Q1.2 (C), R7.1, R9.2
/MPS Stimulator/EDGES: D4.2 (A), D5.2 (A), D6.2 (A), D7.2 (A), R21.1, TP6.1
/MPS-7: Q4.2 (C), R22.1, R23.1, TP5.1; also elsewhere on the board
/MPS-8: D4.1 (K); also elsewhere on the board
/MPS-10: R24.2, RV2.2, TP8.1; also elsewhere on the board
/MPS-15: R10.1, R12.1; also elsewhere on the board
/MPS_PULSE: R27.1, R28.2, TP9.1; also elsewhere on the board
/MPS_STIMULUS: R30.2; also elsewhere on the board
GND: Q1.3 (E), Q2.3 (E), Q3.3 (E), Q4.3 (E), Q5.3 (E), R13.1, R15.1, R20.1, R24.1, R25.2, R28.1, RV1.2, TP2.1, TP4.1; also elsewhere on the board
unnamed: C14.2, D6.1 (K), R14.1, R15.2
unnamed: C15.2, D7.1 (K), R19.1, R20.2
unnamed: C16.1, Q4.1 (B), R17.1
unnamed: C16.2, R18.1
unnamed: D3.1 (K), R10.2
unnamed: D3.2 (A), R6.1, R8.1
unnamed: D5.1 (K), Q3.1 (B), R13.2, R18.2
unnamed: Q1.1 (B), R30.1, TP3.1
unnamed: Q2.1 (B), R9.1
unnamed: Q3.2 (C), R16.1, R17.2
unnamed: Q5.1 (B), R23.2, R25.1
unnamed: Q5.2 (C), R26.1, R27.2
unnamed: R6.2, RV1.1, TP1.1

Notes on the sheet:
Air temp sensor
YELLOW
BROWN

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
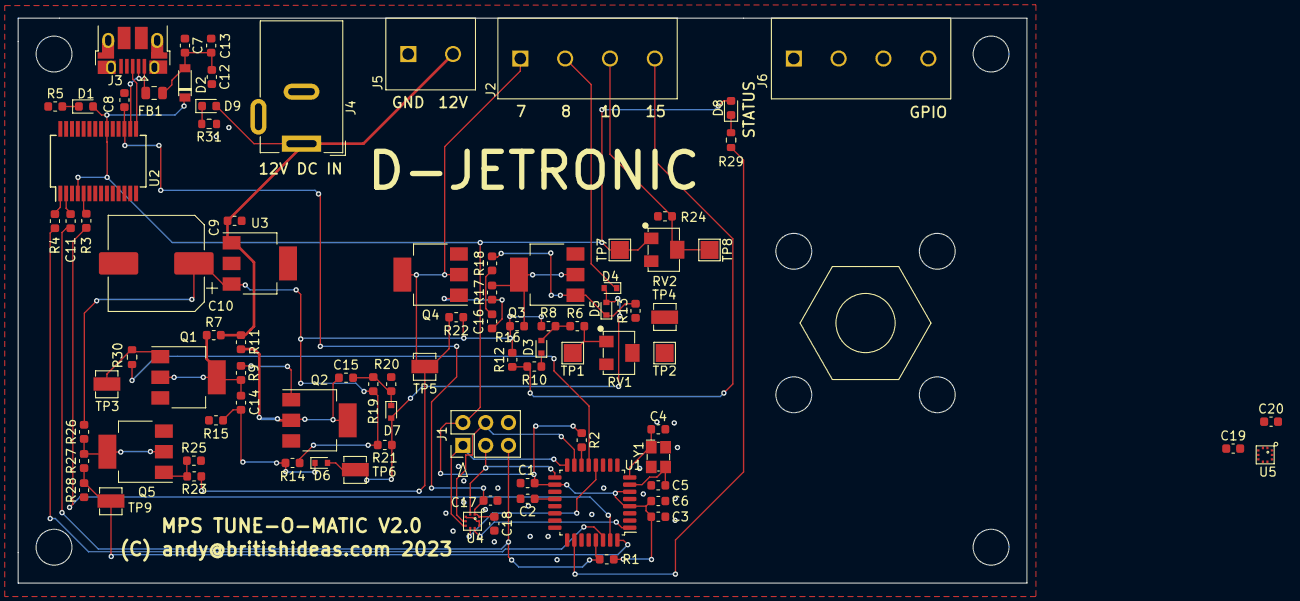
[picture p30: board MPS Tune-o-Matic.kicad_pcb from above]

Board: 2 copper layers, 112.5 x 63.0 mm, 89 parts (0 on the bottom side), 54 nets.
