ajayre/mpstune-o-matic/Firmware/MPS Tune-o-Matic/src/main.cpp

// D-Jetronic MPS Tune-o-Matic
// (C) andy@britishideas.com 2022

#include <Arduino.h>
#include "Serial.h"
#include "Tuner.h"

#define MAJOR_VERSION 1
#define MINOR_VERSION 0
#define PRODUCT_UID   0x02   // Tune-o-Matic

// initialization
void setup() {
  Serial_Init(MAJOR_VERSION, MINOR_VERSION, PRODUCT_UID);
  Tuner_Init();
}

// continually called
void loop() {
  Serial_Process();
  Tuner_Process();
}
