ajayre/mpstune-o-matic/(commit log)

2021-12-06 Started schematic.
    [MPS Driver.sch, MPS Tune-o-Matic.kicad_pcb, MPS Tune-o-Matic.sch, Temperature.sch, USBandPower.sch]
2021-12-13 Working on KiCAD simulation of pressure loop to determine what the inputs are.
    [PressureLoop.kicad_pcb, PressureLoop.sch]
2021-12-14 Wprking on simulation of pressure loop.
    [PressureLoop.sch]
2021-12-14 Using a real coupling factor for MPS.
    [PressureLoop.sch]
2021-12-15 Added component for MPS.
    [PressureLoop.sch]
2022-02-17 Updated MPS model for simulation.
    [PressureLoop.sch]
2022-02-18 Added more simulation scenarios.
    [PressureLoop.sch]
2022-02-18 Added waveforms and schematic diagram images. Added description.
2022-02-18 Added annotated schematics.
2022-02-18 MPS stimulation simulation.
    [MPSStimulator.kicad_pcb, MPSStimulator.sch]
2022-02-20 Generates a 0-5V output.
    [MPSStimulator.sch]
2022-02-20 Completed stimulator. Added example waveforms.
    [MPSStimulator.sch]
2022-02-21 Completed schematic. Started work on PCB.
    [MPS Tune-o-Matic.sch, MPSStimulator.sch, USBandPower.sch]
2022-02-23 Working on PCB layout.
    [MPS Tune-o-Matic.kicad_pcb, MPS Tune-o-Matic.sch, MPSStimulator.sch]
2022-02-24 Completed PCB layout.
    [MPS Tune-o-Matic.kicad_pcb, MPS Tune-o-Matic.sch]
2022-02-25 Working on case.
    [M2 x 0.4mm Thread 18mm LONG SOCKET HEAD CAP SCREW.STEP, M2 x 0.4mm Thread HEX NUT.STEP]
2022-02-25 Moved DB9 connector and regenerated CAD files.
    [MPS Tune-o-Matic.kicad_pcb]
2022-02-25 Started case design.
2022-02-28 Pressure loop simulation now outputs dwell in degrees.
    [PressureLoop.sch]
2022-03-01 Added simulation of contact bounce.
    [PressureLoop.sch]
2022-10-31 Added status LED, remove LCD connectors, changed MPS connector to screw terminal block, added 12V power connections, removed 5V to 12V boost converter. Completely reworked PCB. Removed old PCB CAD fi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
    [MPS Tune-o-Matic.kicad_pcb, MPS Tune-o-Matic.sch, MPSStimulator.sch, USBandPower.sch]
2022-10-31 Generated CAD model of PCB.
2022-10-31 Deleted old case.
    [M2 x 0.4mm Thread 18mm LONG SOCKET HEAD CAP SCREW.STEP, M2 x 0.4mm Thread HEX NUT.STEP]
2022-10-31 Added new case.
2022-10-31 Added ground vias. Fixed voltage mistake for power LED.
    [MPS Tune-o-Matic.kicad_pcb, MPS Tune-o-Matic.sch, MPSStimulator.sch, USBandPower.sch]
2022-10-31 Added PCB manufacturing files.
    [MPS Tune-o-Matic-B_Cu.gbr, MPS Tune-o-Matic-B_Mask.gbr, MPS Tune-o-Matic-B_Paste.gbr, MPS Tune-o-Matic-B_SilkS.gbr, MPS Tune-o-Matic-Edge_Cuts.gbr, MPS Tune-o-Matic-F_Cu.gbr, MPS Tune-o-Matic-F_Mask.gbr, MPS Tune-o-Matic-F_Paste.gbr]
2022-11-01 Added pressure sensor.
    [MPS Tune-o-Matic-B_Cu.gbr, MPS Tune-o-Matic-B_Mask.gbr, MPS Tune-o-Matic-B_Paste.gbr, MPS Tune-o-Matic-B_SilkS.gbr, MPS Tune-o-Matic-Edge_Cuts.gbr, MPS Tune-o-Matic-F_Cu.gbr, MPS Tune-o-Matic-F_Mask.gbr, MPS Tune-o-Matic-F_Paste.gbr]
2022-11-01 Updated case and CAD model of PCB.
2022-11-01 Added case STL files.
    [Bottom.stl, Top.stl]
2022-11-02 Updated 3D model - better screw terminals.
2022-11-04 Added flashing status LED.
2022-11-10 Added LED for 12V power. Added resistor on MPS_STIMULUS signal. Moved track away from mounting hole. Fixed orientation of diodes. Added PDF of schematic. Updated manufacturing files.
    [MPS Tune-o-Matic-B_Cu.gbr, MPS Tune-o-Matic-B_Mask.gbr, MPS Tune-o-Matic-B_Paste.gbr, MPS Tune-o-Matic-B_SilkS.gbr, MPS Tune-o-Matic-Edge_Cuts.gbr, MPS Tune-o-Matic-F_Cu.gbr, MPS Tune-o-Matic-F_Mask.gbr, MPS Tune-o-Matic-F_Paste.gbr]
2022-11-11 Added hole for 12V power LED in top of case.
    [Top.stl]
2022-11-11 Flashes status LED faster when continuous measurement is enabled.
2022-11-12 Added calibration procedure.
2022-11-28 Added BOM and updated notes.
    [MPS Tune-o-Matic.xlsx]
2023-09-29 Started work on V2.0 with vacuum monitoring.
    [MPS Tune-o-Matic.kicad_pcb, MPS Tune-o-Matic.sch, MPSStimulator.sch, Pressure Connector.stp, USBandPower.sch]
2023-11-09 Fixed typos in calibration steps.
